MackaJunest/Turbo-Drive/Turbo_Drive_V1.0/SCH_Schematic_2024-05-30.pdf

IO0 27 IO35 28 IO36 29 IO37 30 IO38 31 IO39 32 IO40 33 IO41 34 IO42 35 RXD0 36 TXD0 37 IO2 38 IO1 39 GND 40

USB to UART | MCU

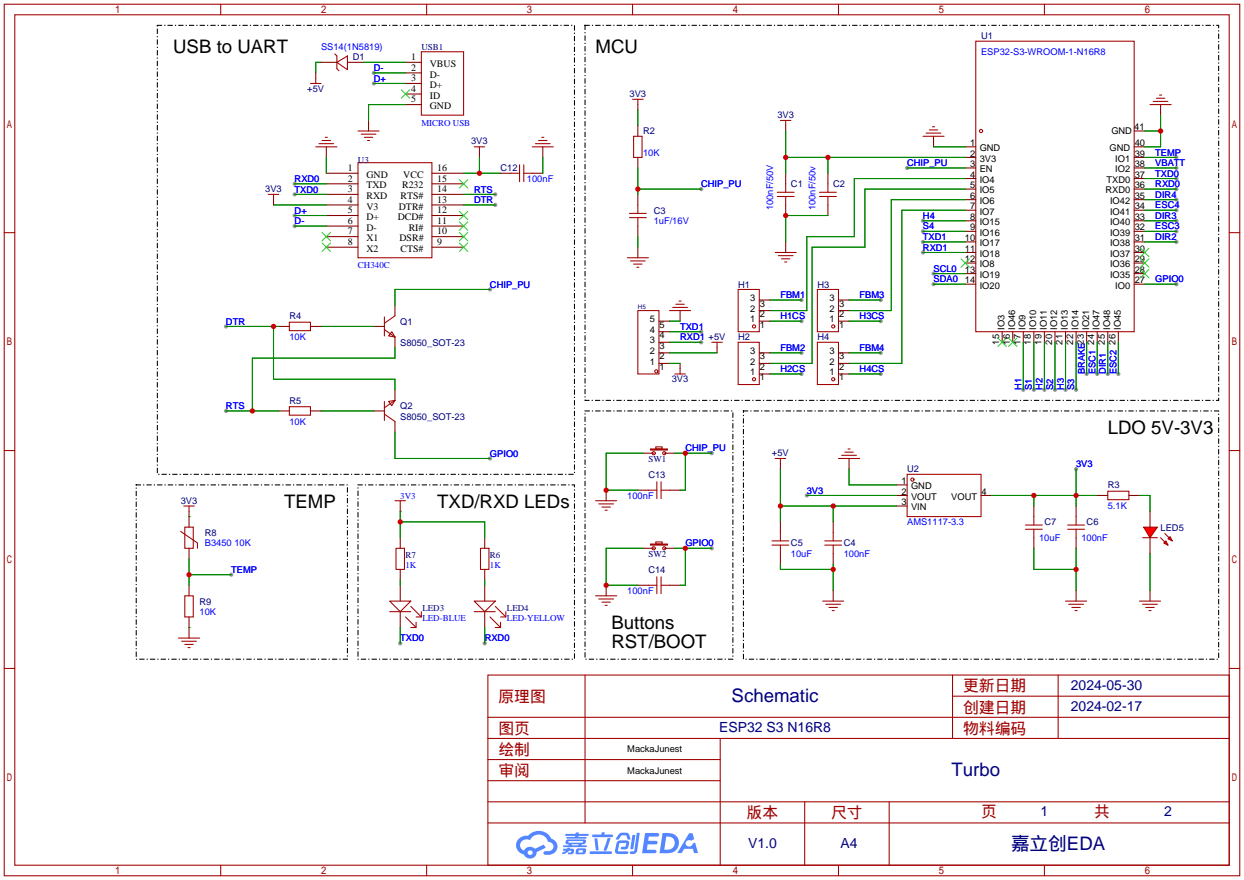
[picture p1: page 1]

Power Supply | Servo Out | Wheel Motors Out Brake Relay

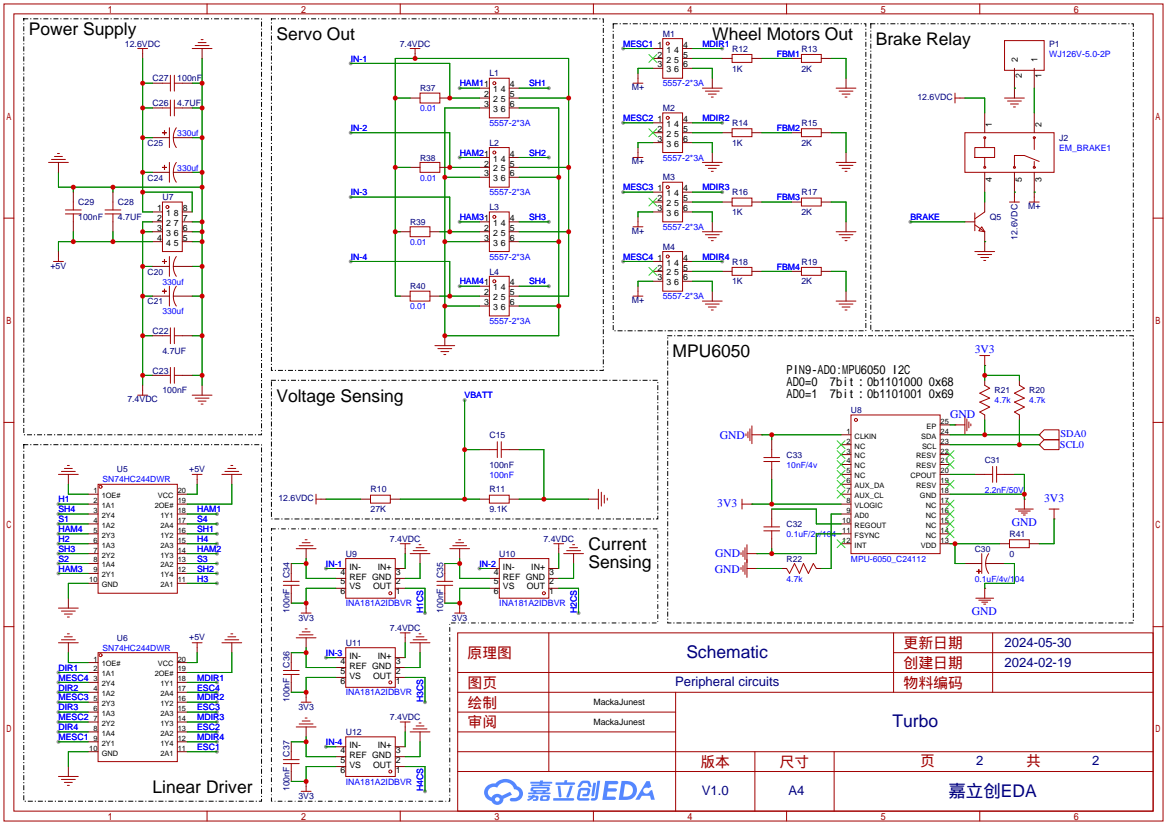
[picture p2: page 2]
