MackaJunest/Turbo-Drive/(list of files, drawings)

Other design files:
Turbo_Drive_V1.0/ProProject_Turbo_Drive_2024-05-30.epro
